bingran/iSEB-PLC/PLC_Board.png

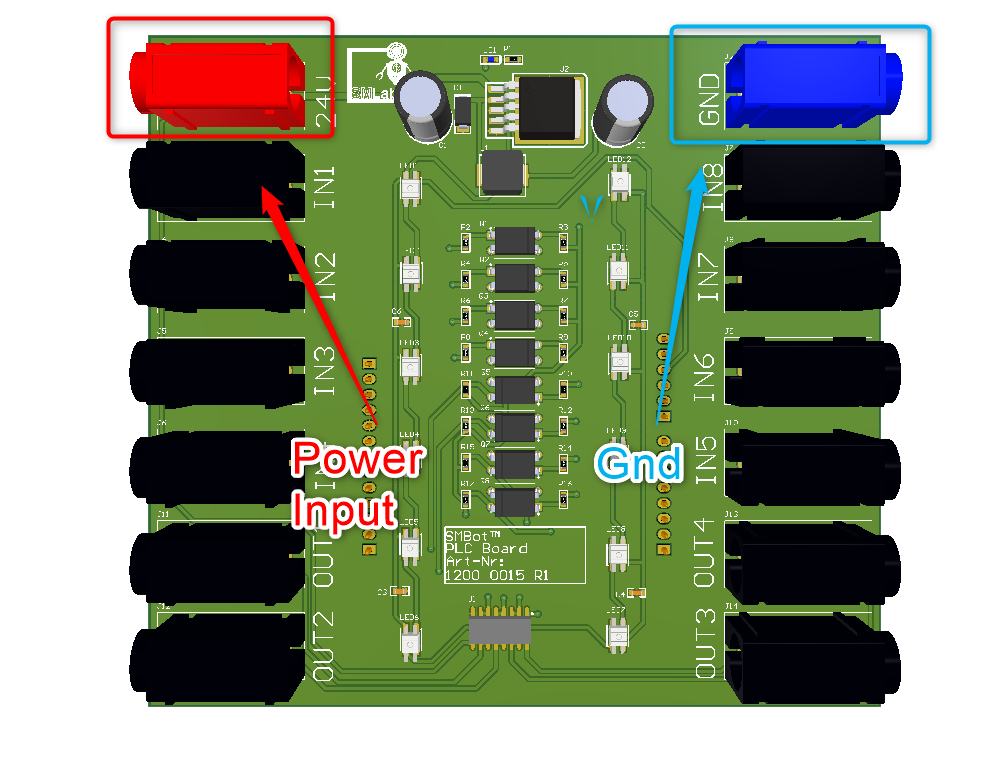
PLC_Board.png
