bingran/iSEB-PLC/iSEB_PLC_2312.step

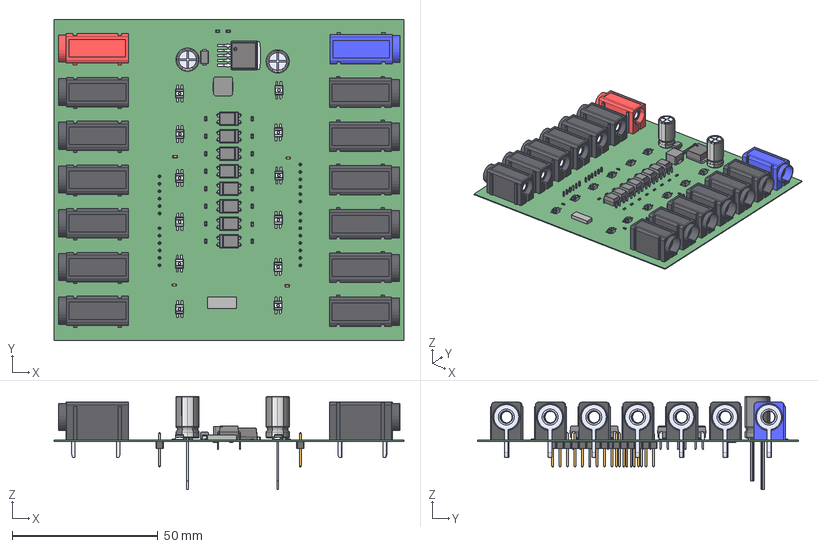
[picture p8: CAD file, 2024-01-22]
iSEB_PLC_2312.step
120.0 x 110.0 x 32.0 mm
Capsule x 17
Encapsulation x 34
TopCover x 17
PC817C x 8
24.243.1--3DModel-STEP-56544-Black_v1 x 12
6-Pin_Header_-_Male_-_2.54mm x 3
Extruded
24.243.1--3DModel-STEP-56544-Blue_v1
TO263-5-1
LED_SK6812MINI-E x 12
LED_Blue_SMD_0603_Würth_150060BS55040
SS14
8-Pin_Header_-_Male_-_2.54mm
C0603_040 x 12
