bingran/iSEB-PLC/iSEB_PLC_2401.pdf

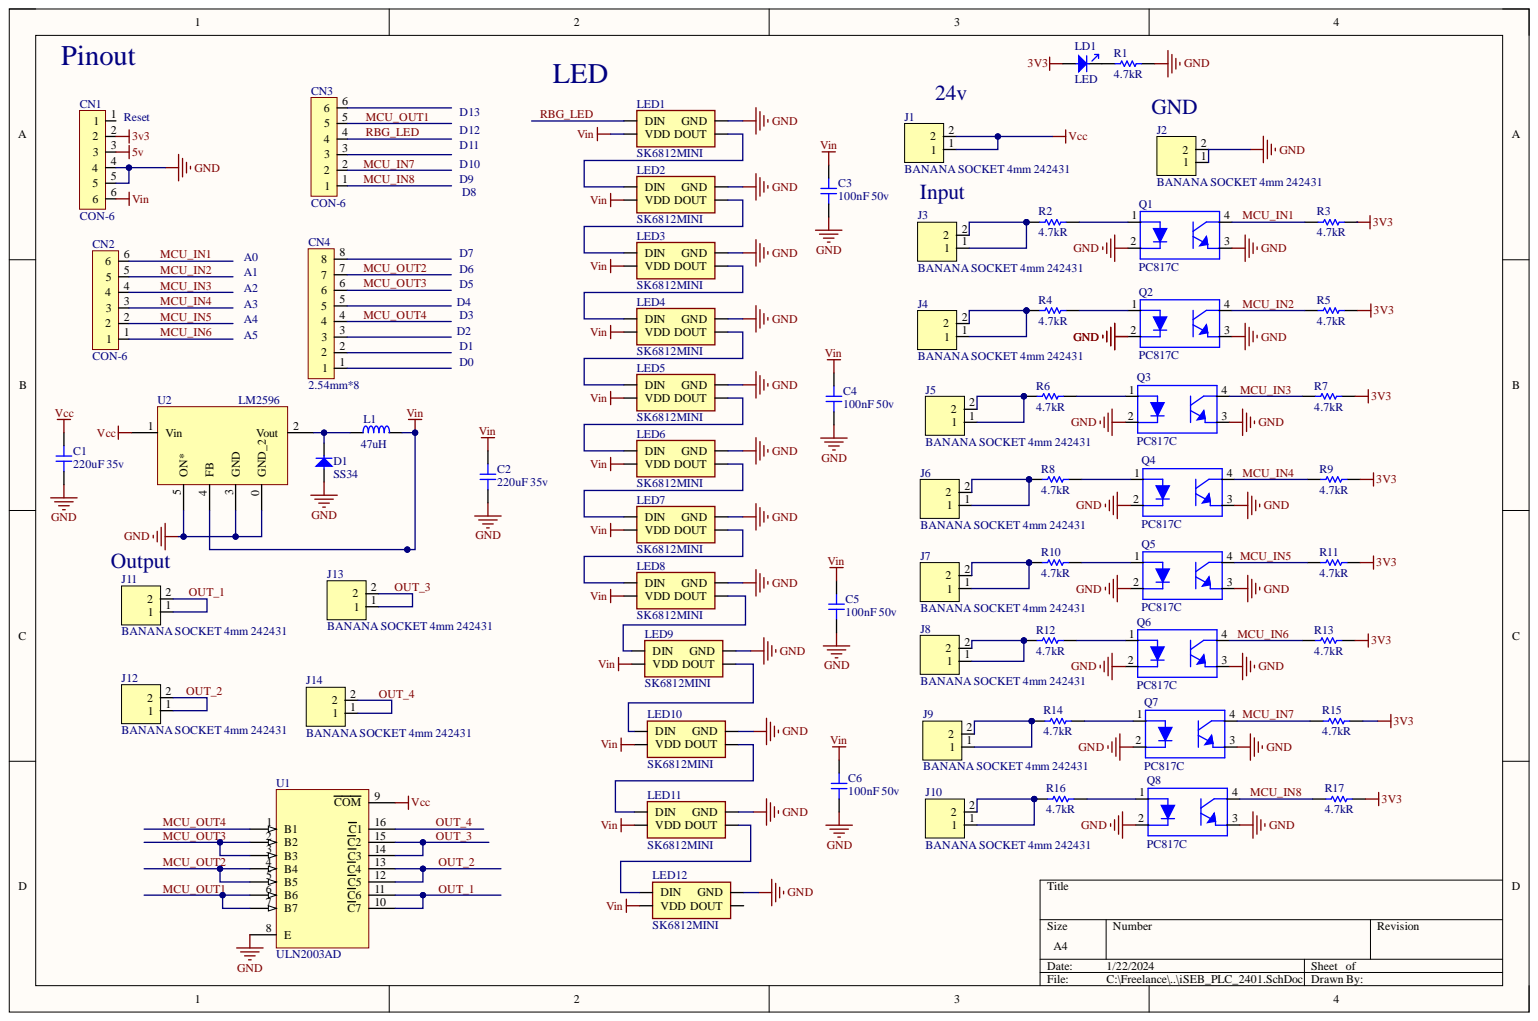
[picture p9: page 1]
