bingran/iSEB-PLC/(commit log)

2024-01-22 Update specification of PLC board
    [iSEB_PLC_2312.step]
2024-05-25 bug fix for Update DO case
    [iSEB-PLC_Gred2_Exercise1.ino, rgbled.ino]
